MarkusMaximusMilanovici/Diplomarbeit/Simulationen_und_Dokumentationen/Dokumentationen/Schule/Präsentation-Jahresprojekt.pptx

## Black Mirror

- Diplomarbeit 22.05.2026

Robert Milanovici & Manuel Greinix
Abteilung für Elektronik und Technische Informatik

## Ziel

- Raspberry Pi Camera
- Silhouette erstellen
- Auf die LEDs Skalieren
- Anzeige

## Programm Start

- Initialization
- Kamera starten
- KI-Modelle
- KNN starten

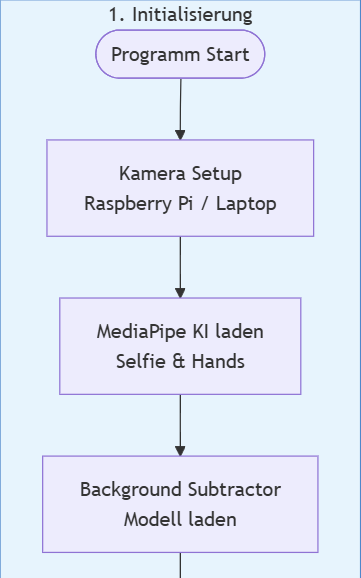
[picture p49: figure]

## Kalibrierung

- 100 Frames ( Keine Person )
- BGR -> Graustufenbild
- KNN lernt Hintergrund

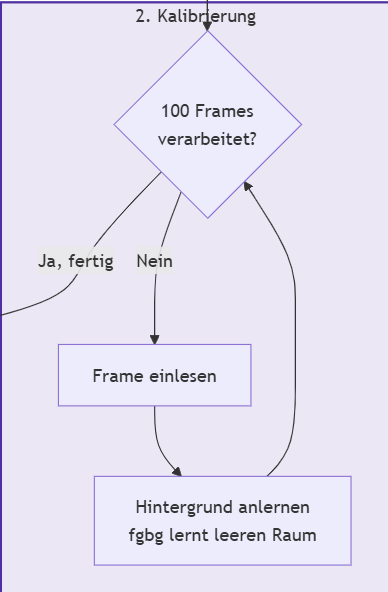
[picture p50: figure]

## Main Loop

- BGR -> RGB
- Körper von Hintergrund trennen
- Hände Polygon
- Maske erstellen

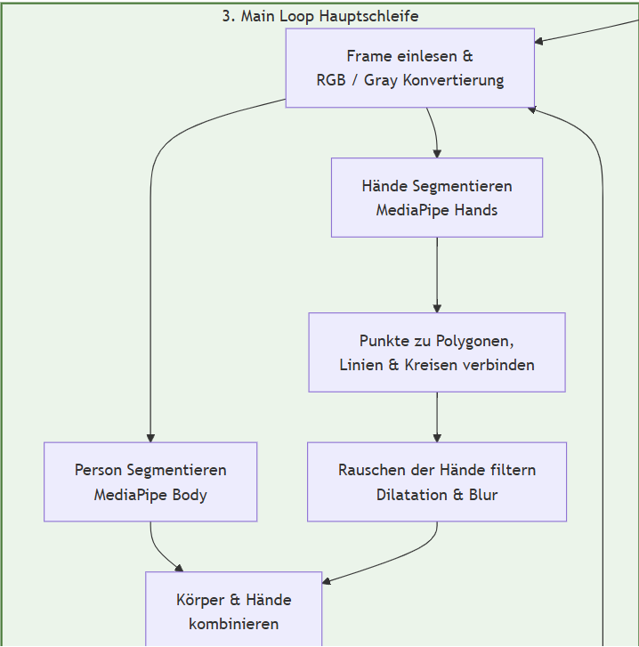
[picture p51: figure]

## Main Loop

- Filter
- Shilouette füllen
- Zeitliche Glättung
- Skalierung

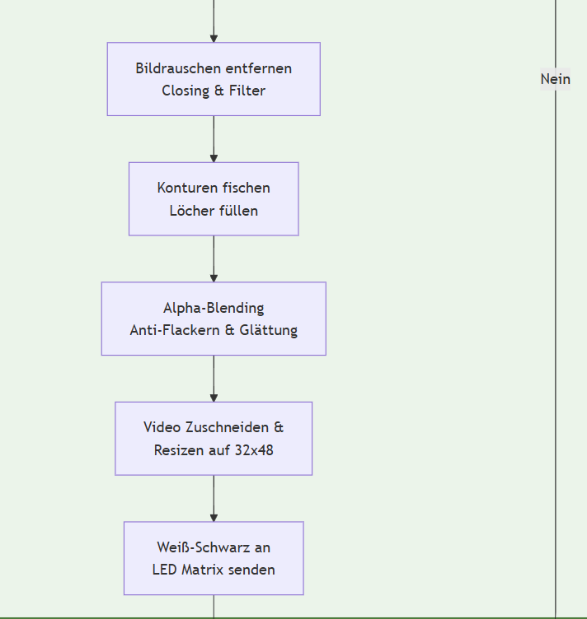
[picture p52: figure]

## Led-Matrix

## Manuel

- Manuel
- Bildübertragung auf LED-Matrix
- Case und Platinen Designe
- Case Fertigung
- Dokumentation und Github Verwaltung

## Neustrukturiereung Github

- Main-Rework
- Neuer Übersichtlicher Aufbau
  - Software
  - Simulation/Dokumentation
  - Setup Guid
- READMEs mir erklärungen
- Code-Archive

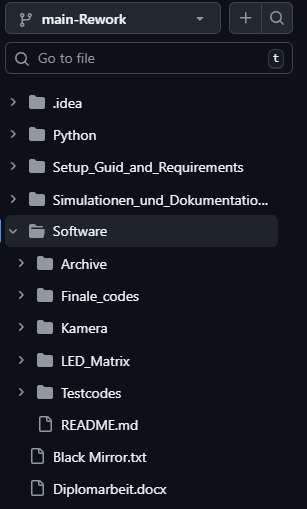
[picture p53: figure]

## Programm Start

- Initialization
- Prüfen ob Raspberry läuft
- Bild wird zerlegt
- 2. 4. und 6. Matrix wird geflippt
- In PIL-Image converten
- Anzeigen

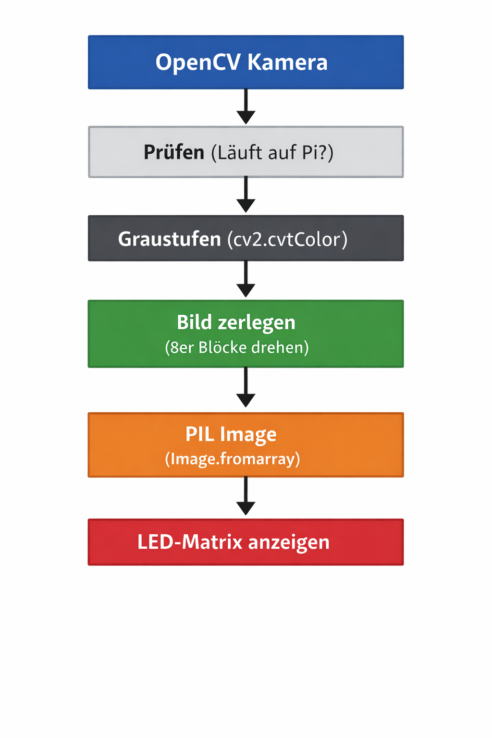
[picture p54: figure]

## Case Design


- Stichpunkte
- Material der Wahl : Holz
- Design Finalisiert
- Für Optimales gerades Bild
  - Opt1: LED-Matrix Einzelteile Abschleifen
  - Opt2: Neuabmessung der Platinen
- Wenn Genug Zeit Case2.0

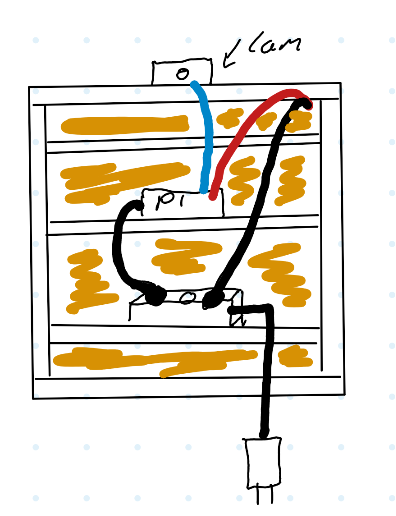
[picture p55: figure]
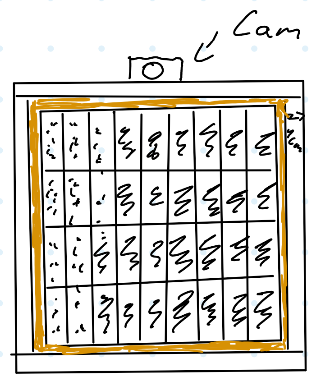
[picture p56: figure]

## Design der Platinen

- Stichpunkte
- Erster simpler Aufbau
- Redesign der neuen Platinen für neue Bauteile
- Bestellen

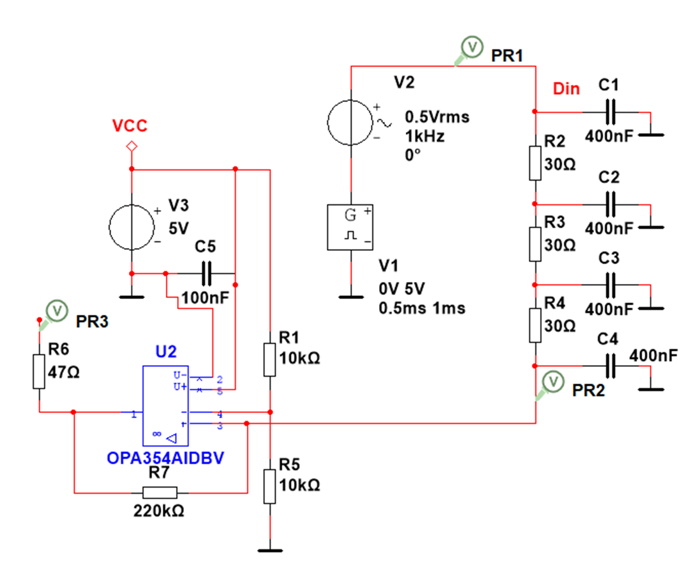
[picture p57: figure]

## Anstehende Punkte

- Finalen Code für die Bildübertragung
- Verbindungsplatinen bestellen, Testen, und Einbauen
- Case Zusammenbauen und Optimieren
- LED-Matrix Stabilisieren und Festigen

## Led Matrix

- OPV Schmit trigger Schaltung
- OPA354 -> hohe Frequenz & Slew Rate
- Signal (blau) wird repariert

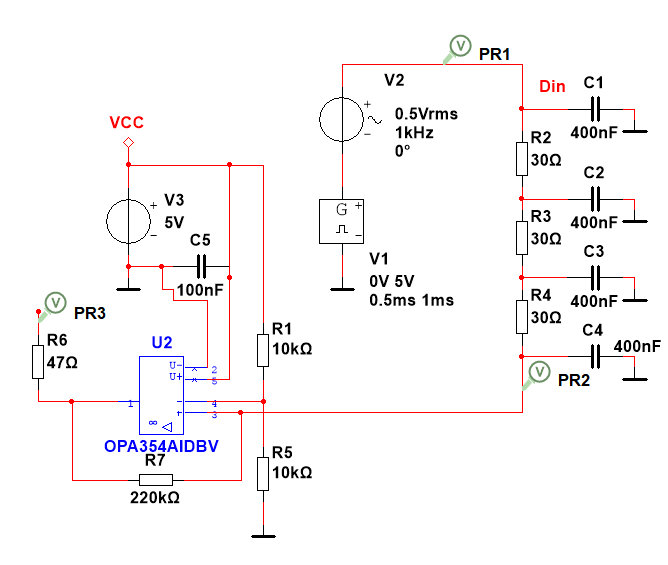
[picture p58: figure]
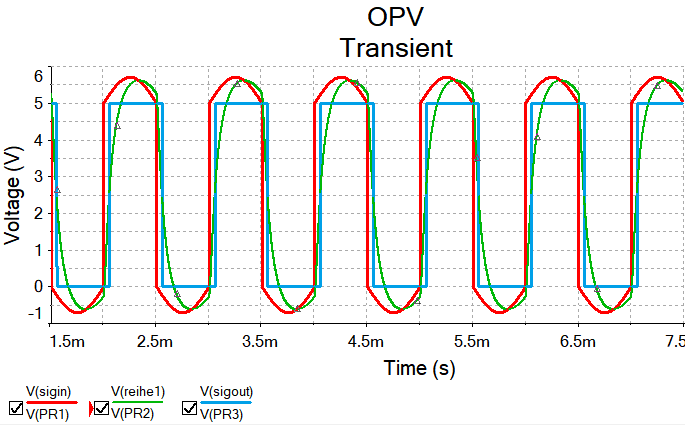
[picture p59: figure]

## Proof of Concept

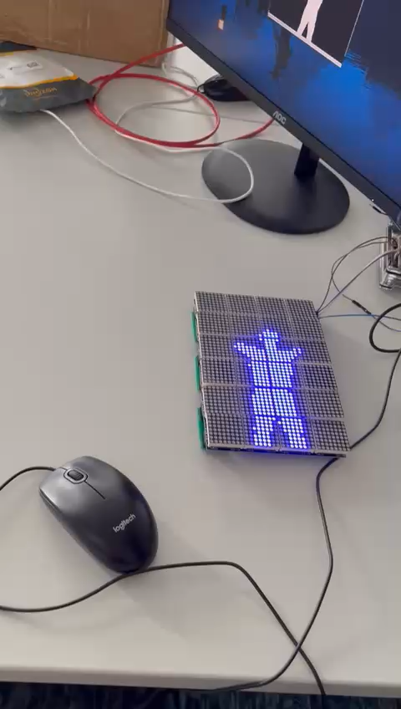
[picture p60: figure]

## Probleme

- Anfänglich:
- Eine stabile Silhouette erstellen
- Eine Case Idee
- Zurzeit:
- Alle 9 Reihen der Led anzusteuern
- Die Finger / Hand präzise anzeigen

## Besonders Aufwendig

- Stabile Silhouette
- Parameter
- Led Module vorbereiten
- Bauteile besorgen

## Aus dem Unterricht gelernt

- HWE / DIC: Hardware Debugging (Zwischenplatinen, OPV)
- DIC: Filter wie Erode und Dilate anwenden (Personenerfassung)

## Zusammenfassung

- ….wichtigste 3-4 Punkte
