MarkusMaximusMilanovici/Diplomarbeit/Simulationen_und_Dokumentationen/Dokumentationen/Schule/5BHEL_Greinix_Milanovici_BlackMirror.pptx

## Der Black Mirror

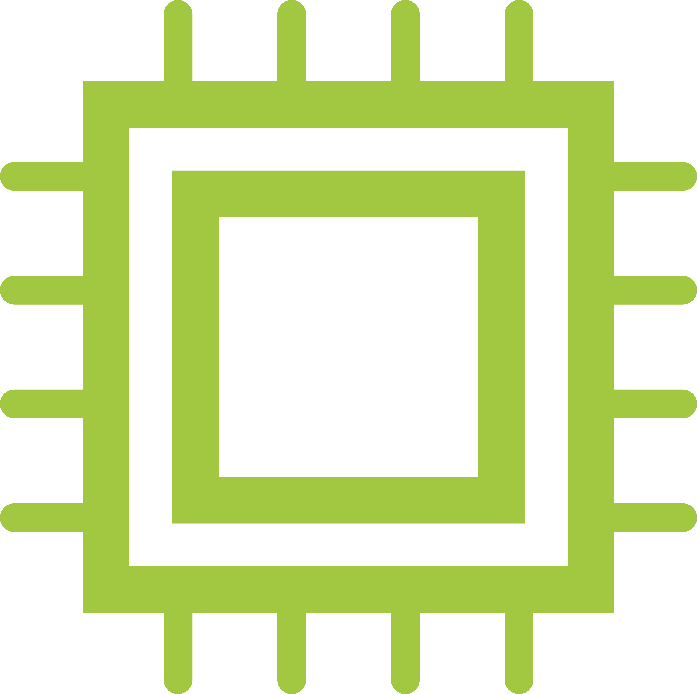
[picture p61: figure]

- Black Mirror spiegelt deine Bewegungen in Echtzeit als digitale Silhouette auf einer LED-Matrix wider.

Die Diplomarbeit „Black Mirror“ kombiniert Kamerasensorik mit künstlicher Intelligenz. Das System erfasst Personen in Echtzeit, trennt sie vom Hintergrund und wandelt ihre Gestik in eine stilisierte Silhouette um. Diese wird verzögerungsfrei auf einer LED-Matrix gespiegelt und erzeugt ein faszinierendes Zusammenspiel aus Bewegung und digitalem Abbild.

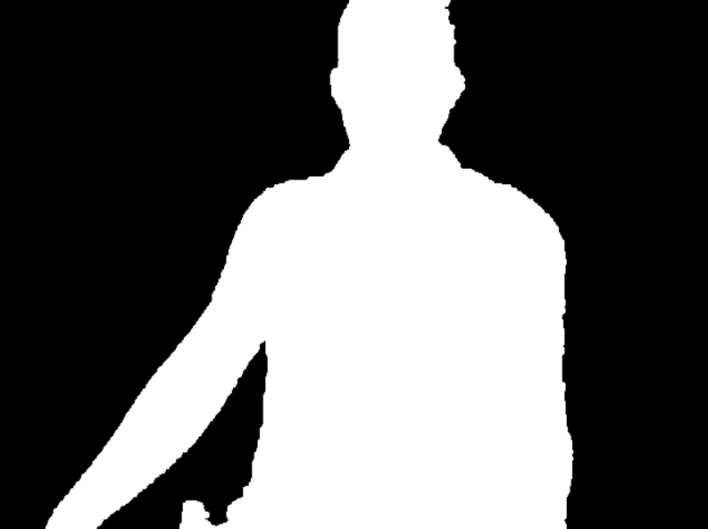
[picture p62: figure]
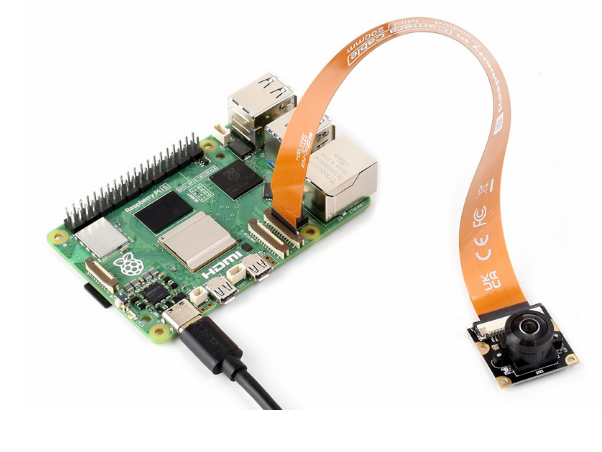
[picture p63: figure]
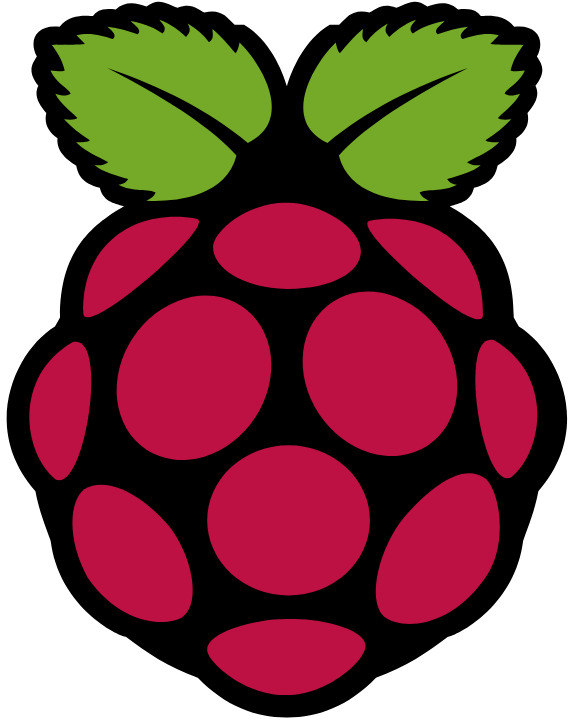
[picture p64: figure]

Verwendete Technologien
Raspberry Pi & PiCamera
Python, OpenCV & MediaPipe
Adressierbare LED-Matrix
CAD & 3D-Druck


LASS DEINE IDEEN LEBENDIG WERDEN

Betreuer

Diplomanden
Robert Milanovici
Manuel Greinix

Prof. DI Patz Franz Albert

Aufgabenbereich
Entwicklung der Bildverarbeitungs-Software
Implementierung der KI-Algorithmen
Hardware-Ansteuerung der LED-Matrix
Gehäusekonstruktion & 3D-Design

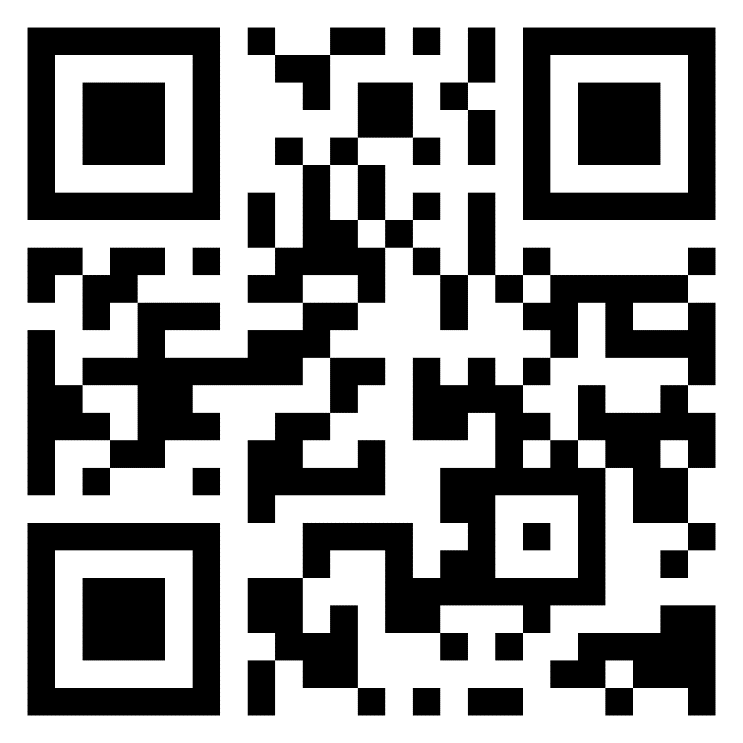
[picture p65: figure]
