MarkusMaximusMilanovici/Diplomarbeit/Simulationen_und_Dokumentationen/Dokumentationen/Diplomarbeit_Verzeichnise/Lastenheft-BlackMirror (1) (1).docx

# 1 Projektziel

Spezifisch:
Es soll ein System namens BlackMirror entwickelt werden, das mithilfe einer Kamera Objekte und Personen erkennt und die erfassten Bilder bzw. eine abstrahierte Darstellung in Echtzeit auf einer LED-Matrix (29 × 52 cm) visuell wiedergibt.

Messbar:
Das System gilt als erfolgreich umgesetzt, wenn folgende Punkte erfüllt sind:
- Kamera kann Personen und Objekte zuverlässig erfassen.
- Erfasste Bilddaten werden auf der LED-Matrix korrekt dargestellt.
- Darstellung erfolgt mit einer sinnvollen Bildrate ohne wahrnehmbare Verzögerung.

Attraktiv:
BlackMirror kombiniert moderne Bilderkennung mit kreativer Visualisierung. Es ist technisch spannend (Computer Vision, Elektronik, LED-Steuerung) und ästhetisch ansprechend – ideal für Ausstellungen, smarte Displays oder interaktive Kunstprojekte.

Realistisch:
Mit gängigen Komponenten (z. B. Raspberry, LED-Matrix, Python/OpenCV) ist das Projekt im Rahmen von Schulressourcen und Teamgröße realisierbar.

Terminiert:
Das Projekt wird innerhalb des vorgegebenen Zeitrahmens (ca. 250–300 Stunden) umgesetzt. Der erste funktionsfähige Prototyp soll bis zum Tag der offenen Tür März 2026 präsentiert werden.

# 2 Nutzen des Produktes

- Vorteile
  - BlackMirror verbindet Technologie, Kunst und Interaktion – es zeigt in Echtzeit, wie Technik menschliche Bewegung und Präsenz erfassen kann.
- Beschreibung
  - Das System erkennt eine Person oder ein Objekt vor der Kamera und spiegelt die erfassten Formen oder Silhouetten auf einer LED-Matrix wider – wie ein „digitaler Spiegel“.
- Welchen Nutzen/Vorteil hat der Anwender des Produkts gegenüber vorher?
  - Visuell beeindruckendes, interaktives Display.
  - Lässt sich an viele Einsatzszenarien anpassen (z. B. Kunst, Werbung, Bildung und Dekoration).
- Nachteile bei nicht Realisierung des Produktes
  - Fehlende innovative Projektarbeit im Bereich Computer Vision.
  - Verpasste Chance kreative Technologie zu präsentieren.
- Welchen Vorteil hat das Projektergebnis gegenüber anderen/eventuell bereits bestehenden Lösungen?
  - Kombination aus Echtzeit-Bilderkennung und großflächiger LED-Visualisierung ist selten.
  - Hoher Wiedererkennungswert durch die interaktive Darstellung.

# 3 Kunden, Anwender, Zielmarkt

- Auftraggeber/Endnutzer
  - Auftraggeber: Projekt/Diplomarbeit Endnutzer: Kunst & Designliebhaber , Dekoration Öffentlicher Flächen wie z.B: Einkaufszentren DIY-Smart-Home Umfeld Mögliche Interessenten: Installationen in Galerien oder Events.
- Mögliche Interessenten nach Adaption
  - Büros & Co-Working-Spaces
- Berührungspunkte
  - Endnutzer
  - Entwickler / Techniker (Installation & Wartung)
- Potenzielle Anbieter des Produktes
  - Elektronik- oder Maker-Shops, Bildungseinrichtungen, Smart-Display-Hersteller, Großhändler.

# 4 Anforderungen

- Hauptfunktionen:
  - Kameraerfassung von Personen oder Objekten.
  - Verarbeitung des Bildes (z. B. Kantenerkennung, Silhouettierung).
  - Ausgabe auf einer LED-Matrix.
- Potenzielle Anforderungen / Extrawünsche des Kunden
  - Spezialanfertigungen (Größe, bzw Material)
- Mögliche Zusatzfunktionen
  - Erkennung mehrerer Personen gleichzeitig.
  - Anpassbare Darstellung (z. B. Kontrast, Auflösung).
- Verbesserung des Produkts
  - Hochwertigeres Grunddesign bzw Case
- „nice to have“?
  - Personalisierung des außen Designs Möglichkeiten (Muster ,generelles Design Selber bei kauf optional Festlege)
- Wichtige Attribute
  - Stabiler Betrieb ohne Verzögerungen.
  - Kompakte, ästhetische Bauform.
  - Energieeffiziente Steuerung der LED-Matrix.

# 5 Randbedingungen

- Unveränderliche Eigenschaften
  - Kamera
  - LED Matrix
  - Maximalgröße (wegen Budget)
- Kompatibilität
  - Evtl. Smartphone
- Versorgung
  - Netzteil

# 6 Chancen und Risken

- Lokale Märkte für das Produkt
  - Einkaufszentren , Haushalte
- Voraussichtliche Kundenfelder
  - Private Haushalte mit Technikaffinität: Österreich hat ca. 4 Mio. Haushalte – ein kleiner, aber technikinteressierter Teil (~1–2 %) davon wäre potenziell interessiert. → ca. 40.000–80.000 Haushalte
  - Kleinunternehmen & Büros: Etwa 350.000 Unternehmen, viele davon Kleinbetriebe oder Kanzleien, wollen vielleicht technologische Dekoration → ca. 500 –100 potenzielle Firmenkunden
  - Maker-Szene / Bildungseinrichtungen: Schulen, FHs, Tüftler – kleinere Stückzahlen, aber hohes Interesse an Innovation. → ca. 1.000–2.000 Verkäufe/Jahr
- Voraussichtliche Verkäufe Pro Jahr( Exponentiell mehr pro Jahr)
  - Zwischen 500-1500 im Jahr
- Verglichen mit der Konkurrenz
  - Innovativ und hat keinen wirklichen Vergleich
- Kosten für das Produkt
  - Zwischen 350-400€
- Nicht einplanbare Hindernisse
  - Attraktivität des Produktes bei Käufern
- Externer Gebrauch der Benötigt wird
  - Bei Verkaufbaren Produkt: Zusatzzubehör wie Kabel und Stromversorgung

# 7 Aufwandsabschätzung

- Herstellungskosten des Prototypen
  - Gesamt ca 350 Euro
- Kosten des Produktes
  - Hardware | Kamera, µC, LED-Matrix, Netzteil | ca. 300 €
  - Sonstiges | Kabel, Gehäuse, Halterungen | ca. 50 €
- Zeit die für Entwicklung gebraucht werden wird
  - 250-300 Stunden
- Anzahl notwendiger Mitarbeiter
  - 2 Personen
- Wichtige Kenntnisse der Arbeiter
  - Hardwaredesign
  - Bibliotheken: OpenCV, LED-Matrix-Controller
  - Programmierung (Python / OpenCV)
  - Optional: 3D-Druck
- Ist externe Unterstützung notwendig?
  - Zu diesem Zeitpunkt nicht beurteilbar, voraussichtlich wenig Unterstützung nötig
- Fertigstellung des Ersten Prototypen
  - Ziel : Tag der offenen Tür
- Start für eine Serienfertigstellung
  - Ende 2027
- Kosten Pro Stück
  - 550€

WS2000 Projektantrag.doc 14 von 1

Greinix/Milanovici Seite 1 von 2

Skriptum Technische Informatik

Lastenheft BlackMirror Klasse 5BHEL 01.03.2026 Version 1.0
