MarkusMaximusMilanovici/Diplomarbeit/Simulationen_und_Dokumentationen/Dokumentationen/Diplomarbeit_Verzeichnise/Verzeichnis_Diplo.docx

1. Einleitung

1.1 Motivation und Problemstellung
1.2 Zielsetzung der Diplomarbeit
1.3 Abgrenzung und Rahmenbedingungen
1.4 Aufbau der Arbeit

2. Grundlagen

2.1 Bildverarbeitung und Computer Vision
2.2 Künstliche Intelligenz in der Bildanalyse
2.3 Medien- und LED-Display-Technik
2.4 Git, Versionsverwaltung und Entwicklungsumgebung

3. Analyse und Anforderungen

3.1 Ausgangssituation und Ideenfindung („Black Mirror“)
3.2 Funktionale Anforderungen (Was soll das System können?)
3.3 Nicht-funktionale Anforderungen (Echtzeit, Robustheit, Sicherheit)
3.4 Use Cases und Szenarien
3.5 Systemgrenzen und Annahmen

4. Systemkonzept und Architektur

4.1 Gesamtüberblick des Systems
4.2 Hardwarearchitektur
4.2.1 Raspberry Pi und Kamera
4.2.2 LED-Matrix und Ansteuerung
4.2.3 Weitere Komponenten (Netzteil, Rahmen, Gehäuse)
4.3 Softwarearchitektur
4.3.1 Schichtenmodell und Module
4.3.2 Datenfluss vom Kamerabild zur LED-Matrix
4.3.3 Schnittstellen zwischen den Komponenten

5. Verwendete Technologien

5.1 Programmiersprache und Bibliotheken (Python, OpenCV, NumPy)
5.2 MediaPipe Selfie Segmentation und Hands
5.3 Bildverarbeitungs- und Filterverfahren (Thresholding, Morphologie, Kanten)
5.4 Kommunikations- und Protokollkonzepte zur LED-Ansteuerung
5.5 Entwicklungswerkzeuge (IDE, GitHub, Testumgebung)

6. Implementierung

6.1 Vorbereitung und Initialisierung der Kamera
6.2 Vorverarbeitung der Kamerabilder
6.2.1 Helligkeits- und Kontrastanpassung
6.2.2 Grauwertbilder, Rauschunterdrückung
6.3 Personensegmentierung mit MediaPipe (Selfie Segmentation)
6.3.1 Erzeugung der Binärmaske
6.3.2 Umgang mit Beleuchtung und Threshold-Wahl
6.4 Hand- und Fingererkennung mit MediaPipe Hands
6.4.1 Landmarkerkennung
6.4.2 Einzeichnen der Hände in die Silhouettenmaske
6.5 Hintergrundmodell und Bewegungserkennung (KNN-Subtractor)
6.5.1 Kalibrierungsphase
6.5.2 Nutzung der Bewegungsmaske
6.6 Nachverarbeitung der Maske
6.6.1 Morphologische Operationen (Erosion, Dilatation, Opening, Closing)
6.6.2 Konturenerkennung und Füllen der Silhouette
6.6.3 Zeitliche Glättung der Maske (Frame-übergreifende Stabilisierung)
6.7 Downscaling und Mapping auf die LED-Matrix
6.7.1 Auflösung und Skalierungsstrategien
6.7.2 Umsetzung in das Matrix-Koordinatensystem
6.8 Softwarestruktur und wichtige Codeausschnitte

7. Mechanischer Aufbau und Design

7.1 Gehäusekonzept und Gestaltung des Spiegels
7.2 Montage der LED-Matrix und Kamera
7.3 Kabelmanagement und Sicherheit
7.4 Designüberlegungen (Ästhetik, Benutzerfreundlichkeit)

8. Tests und Evaluierung

8.1 Teststrategie und Testumgebung
8.2 Funktionstests (Erkennung, Anzeige, Bedienung)
8.3 Performance-Messungen (FPS, Latenz)
8.4 Robustheitstests (verschiedene Lichtbedingungen, Kleidung, Hintergründe)
8.5 Grenzen des Systems und typische Fehlerfälle
8.6 Auswertung der Testergebnisse

9. Benutzeroberfläche und Bedienkonzept (falls vorhanden)

9.1 Starten und Beenden des Systems
9.2 Konfigurationsmöglichkeiten (z.B. Helligkeit, Thresholds)
9.3 Benutzerfeedback und Beobachtungen

10. Wirtschaftliche und gesellschaftliche Betrachtung (falls von Schule gefordert)

10.1 Kostenanalyse der Hardware
10.2 Einsatzmöglichkeiten (Schule, Kunstinstallation, Messe, Werbung)
10.3 Datenschutz und ethische Überlegungen (Kamera, Aufnahmen)

11. Zusammenfassung und Ausblick

11.1 Zusammenfassung der erzielten Ergebnisse
11.2 Erfüllung der Zielsetzung
11.3 Mögliche Erweiterungen (z.B. Farben, Gestenerkennung, Multiplayer)
11.4 Persönliche Reflexion

12. Literaturverzeichnis

13. Abbildungsverzeichnis

14. Tabellenverzeichnis (optional)

15. Anhang

15.1 Quellcode-Auszüge
15.2 Schaltpläne und Anschlussdiagramme
15.3 CAD-Zeichnungen / 3D-Modelle
15.4 Testprotokolle und Messdaten
