MarkusMaximusMilanovici/Diplomarbeit/Software/README.md

## Strukturierender Aufbau unserers Software teils der Diplomarbeit
