MarkusMaximusMilanovici/Diplomarbeit/Software/Finale_codes/README.md

## Finale Codes

Hier werden die finalen codes für das Endprodukt sein
