MarkusMaximusMilanovici/Diplomarbeit/Software/Kamera/README.md

## Detection_with_Mediapipe
### Dieser Code wurde für die Personenerkennung des Balck Mirrors endgültig verwendet 
  Die Personenerfassung und die wandlung auf schwarz und weiß mit KI model Mediapipe durch Errode und Dilate, KNN Subtractor, Kantenerkennung und Opening und Closing
