MarkusMaximusMilanovici/Diplomarbeit/Software/Archive/README.md

## Archive

Hier werden die abgeschlossenen neben projekte und test Archiviert damit man jeder zeit wieder nachschauen kann.
