MarkusMaximusMilanovici/Diplomarbeit/Simulationen_und_Dokumentationen/Dokumentationen/Diplomarbeit_Verzeichnise/Code.png

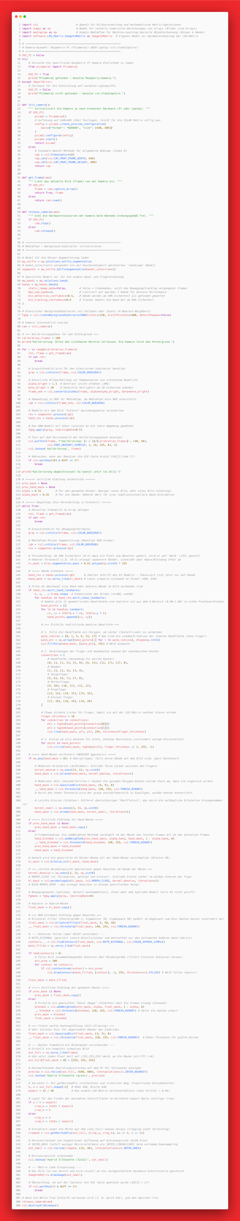
Simulationen_und_Dokumentationen/Dokumentationen/Diplomarbeit_Verzeichnise/Code.png
