MarkusMaximusMilanovici/Diplomarbeit/Simulationen_und_Dokumentationen/Dokumentationen/Diplomarbeit_Verzeichnise/Personenerfassung_Flowchart.png

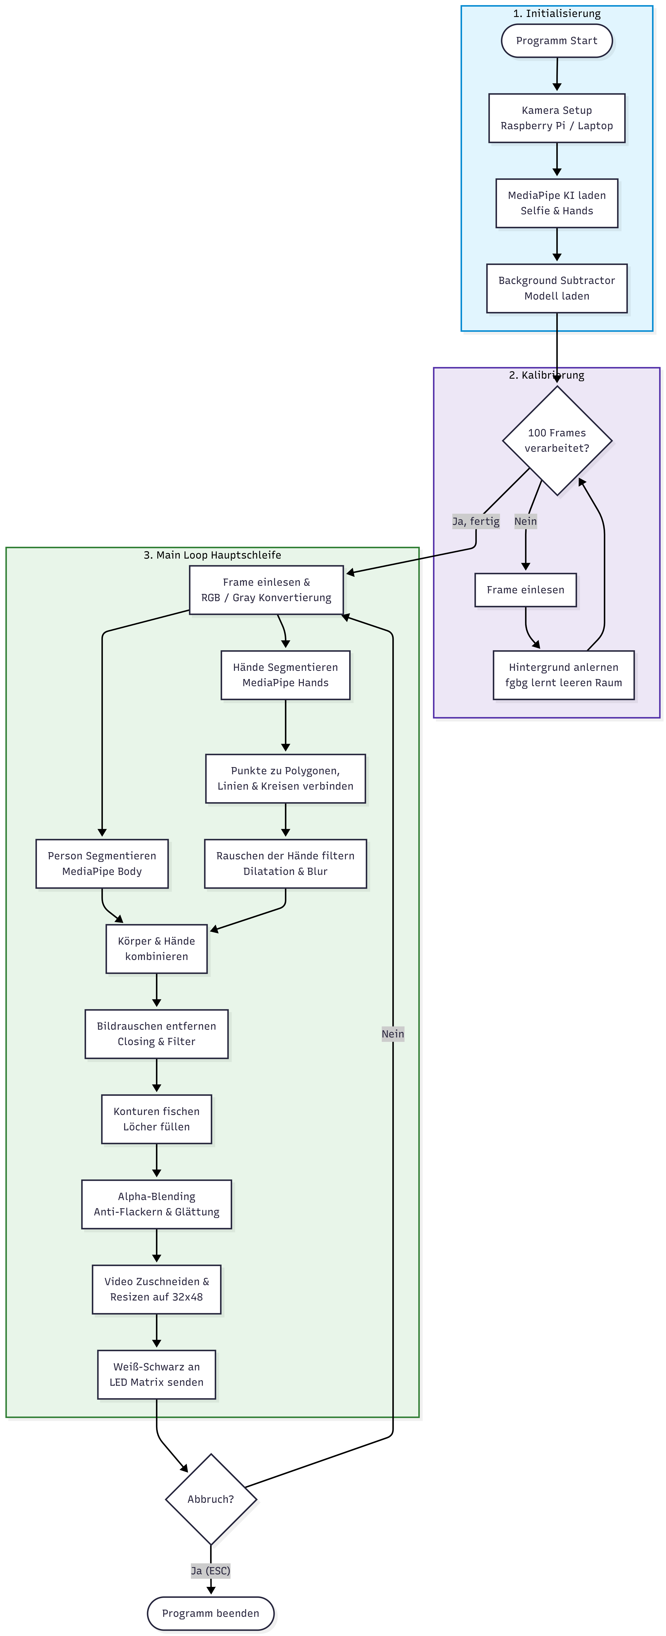
Simulationen_und_Dokumentationen/Dokumentationen/Diplomarbeit_Verzeichnise/Personenerfassung_Flowchart.png
