MarkusMaximusMilanovici/Diplomarbeit/Simulationen_und_Dokumentationen/Dokumentationen/Diplomarbeit_Verzeichnise/Kostentabelle.xlsx

 | BESCHREIBUNG | MENGE | MODELLNUMMER/TEILENUMMER | HERSTELLER-TEILENUMMER | Website | Link | STÜCKPREIS | Versand | GESAMTPREIS
1 | Raspberry Pi 5 8 GB | 1 | Raspberry Pi 5 | Raspberry Pi | Amazon | https://www.amazon.de/dp/B0CK2FCG1K?ref_=ppx_hzod_title_dt_b_fed_asin_title_0_0 | €90.45 |  | €90.45
2 | Twozoh Micro HDMI auf HDMI Kabel 1M | 1 | 1M | Twozoh | Amazon | https://www.amazon.de/dp/B08RB1HKKB?ref_=ppx_hzod_title_dt_b_fed_asin_title_0_2&th=1 | €9.89 |  | €9.89
3 | Raspberry Pi 5 USB-C Netzteil | 1 | EB82182 | Raspberry Pi | Amazon | https://www.amazon.de/dp/B0CN3MRV16?ref_=ppx_hzod_title_dt_b_fed_asin_title_1_0 | €15.90 |  | €15.90
4 | Miuzei Gehäuse für Raspberry Pi 5 | 1 | Boîtier pour Raspberry Pi 5 | Miuzei | Amazon | https://www.amazon.de/dp/B0CN3MRV16?ref_=ppx_hzod_title_dt_b_fed_asin_title_1_0 | €10.99 |  | €10.99
5 | ZDE 2 Stück Kamera Kabel CSI FFC | 1 | ZDE 2PCS | ZDE | Amazon | https://www.amazon.de/dp/B0DQ9KYNB3?ref_=ppx_hzod_title_dt_b_fed_asin_title_2_0 | €7.99 |  | €7.99
6 | Raspberry Pi Camera Modul 3 Wide NoIR | 1 | SC0875 | Raspberry Pi | Amazon | https://www.amazon.de/dp/B0BRY6VLR6?ref_=ppx_hzod_title_dt_b_fed_asin_title_3_1 | €30.99 |  | €30.99
7 | 1 Stück MAX7219 Dot Matrix Modul | 40 | -------------------------------- | --------------- | AliExpress | --------------------------------------------------------------------------------------------------------------- | 2.65 | €47.24 | €152.63
8 | 10 Stück 2,54mm/2mm u-Form einreihiger Stecker | 1 | RA DIP 2.54mm Pin Header | Yu Na Sheng | AliExpress | https://de.aliexpress.com/item/1005007029727065.html | 4.89 | €4.00 | €8.89
9 | Arceli 120 Stück 2,54 mm Gerade einreihige Stieftleisten | 1 | 00 454 | Arceli | Amazon | https://www.amazon.de/dp/B07Q1XBGFB?ref_=ppx_hzod_title_dt_b_fed_asin_title_0_0 | €9.99 |  | €9.99
10 | IC OPAMP VFB 1 CIRCUIT SOT23-5 | 20 | 296-13033-1-ND | OPA354AIDBVT | DigiKey | https://www.digikey.at/de/products/detail/texas-instruments/OPA354AIDBVT/480150 | 1.769 |  | €35.38
11 | RES 10K OHM 5% 1/4W AXIAL | 40 | CF14JT10K0CT-ND | CF14JT10K0 | DigiKey | https://www.digikey.at/de/products/detail/stackpole-electronics-inc/CF14JT10K0/1741265 | 0.0124 |  | €0.50
12 | RES 47 OHM 10% 2W AXIAL | 20 | BC3362CT-ND | PR02FS0204709KR500 | DigiKey | https://www.digikey.at/de/products/detail/vishay-beyschlag-draloric-bc-components/PR02FS0204709KR500/6691138 | 0.239 |  | €4.78
13 | IC BUFF NON-INVERT 5.5V 14-PDIP | 3 | 296-4655-5-ND | SN74AHCT125N | DigiKey | https://www.digikey.at/de/products/detail/texas-instruments/SN74AHCT125N/375798 | 0.69 |  | €2.07
14 | SWITCH ROCKER SPST 10A 125V | 1 | EG5619-ND | RA1113112R | DigiKey | https://www.digikey.at/de/products/detail/e-switch/RA1113112R/3778055 | 0.55 |  | €0.55
15 | +5V2.4A;18AWG/150CM | 1 | 1866-NGE12E05-P1J-ND | NGE12E05-P1J | DigiKey | https://www.digikey.at/de/products/detail/mean-well-usa-inc/NGE12E05-P1J/22118921 | 9.08 |  | €9.08
16 | Holzplatte 20x70 cm | 4 | ------------------------------ | --------------------------------- | Obi Markt |  |  |  | €16.96
17
 |  |  |  |  |  |  |  | mwst. | €10.47
 |  |  |  |  |  |  |  |  | 417.51 €
