MarkusMaximusMilanovici/Diplomarbeit/Software/Testcodes/README.md

## Codes die Grade in verwendung sind die noch nicht ready zum Archivieren sind
