MarkusMaximusMilanovici/Diplomarbeit/Software/Archive/Erster_Kamera_Test/README.md

## main.py

### Testprogramm zur Überprüfung der Kamerafunktion am Raspberry Pi

`main.py` diente in dieser Entwicklungsphase ausschließlich zur grundlegenden Überprüfung der Kamerafunktionalität am Raspberry Pi.

Ziel dieses Programms war es, sicherzustellen, dass:

- die Kamera korrekt erkannt und initialisiert wird  
- ein Livebild ausgegeben werden kann  
- die Auflösung den Anforderungen des Projekts entspricht  
- die Bildqualität der NoIR-Kamera ausreichend ist  

Im Rahmen dieses Tests wurde die Kamera eingeschaltet und das aufgenommene Bild analysiert, um ein erstes Gefühl für:

- Helligkeit  
- Kontrast  
- Bildschärfe  
- Reaktionszeit  

zu erhalten.

Dieses Programm stellte somit eine grundlegende Funktionskontrolle dar und bildete die Basis für die spätere Implementierung der Bildverarbeitung und Personenerkennung.

Es enthält bewusst nur elementare Funktionen und dient nicht als Bestandteil des finalen Systems, sondern als technischer Funktionstest der Hardware.
