MarkusMaximusMilanovici/Diplomarbeit/(list of files, drawings)

Other design files:
Simulationen_und_Dokumentationen/Simulationen/LevelShifter.ms14
Simulationen_und_Dokumentationen/Simulationen/OPV.ms14
