MarkusMaximusMilanovici/Diplomarbeit/(commit log)

2025-11-21 Das gleiche nur mit filter hinterher für mehr detail und pixelentfernung
2025-11-26 Vor dem Knn BAckground Subtractor eine Kalibrierung mit 100 Bilder um zu schauen welche Pixel sich wie ändern und den HIntergrund mit der Person besser zu trennen
2025-11-26 Errode und Dilate nach dem Canny mit 5x5
2025-11-26 Errode und Dilate nach dem Canny mit 5x5 2 mal ausführen
2025-11-26 Errode und Dilate nach dem Canny mit 5x5 vor und nach dem Canny ausführen
2025-11-26 Errode und Dilate nach dem Canny mit 5x5 vor und nach dem Canny ausführen. ISt schlechter weil das errode und Dilate anfänglich auf Graustufenbild. dannch auf binär(schwarz weiß)
2025-11-26 Vor dem Canny ein Errode und dilate, weil einfacher für canny, dann canny, dannch nochmal ein opening und closing für edge map sauberer machen
2025-12-04 mit Picamera anstatt VideoCApture und verwendbar für laptop und Pi
2025-12-04 Das Bild wird um 90 Grad gedreht weil die KAmera4:3 ist und es wird so downgescaled, dass die Leds von 128x72 Pixel das genau anzeigen
2025-12-04 Das Bild wird um 90 Grad gedreht weil die KAmera4:3 ist und es wird so downgescaled, dass die Leds von 128x72 Pixel das genau anzeigen und es wird mit voller Auflösung gerechnet und erst am Ende dowg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
2025-12-04 jetzt wird 32:32 weil das auf die jetztigen Leds abgespielt werden kann
2025-12-04 der Output wird auf der MAtrix angezeigt
2025-12-26 ein bisschen mit den ZAhlen gespielt Threshold und anstadt Maske Konturen verwendet am Ende, soll das Rauschen etwas wegmachen und die Finhger sollen durch die Zahlen Spielerei und durch das Closing 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
2026-01-07 Da die Finger bzw die HAnd nicht gefasst wird, hab ich von MEdiaPipe das HAndtracking genommen wo an den Knöcheln der HAnd Punkte miteinander verbunden. Um die Punkte sollen kleine kreise gemacht wer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
2026-01-07 Den Radius der Kreise kleiner gemacht und am closing der Morpholgie das iterations von 2 auf 1 gewechselt
2026-01-07 Der KNN Subtractor hat ein umgekehrtes Bild Bekommen anfänglich und dannch wieder umgedreht, jetzt bekommt es ein normales Bild
2026-01-07 tracking confidence erhöht von 0.5 auf 0.7 und eine zeitliche Glättung eingefügt wo das letzte Bild mitspielt damit die Hand nicht sofort verschwindet oder wie vorher das sie kurz einfach weggeht
2026-01-08 Helligkeit erhöht damit wenn wie heute schlechtes Licht ist und die Ki bekommt das Bild heller
2026-01-28 mp_hands um etwas kleiner und größer gemacht
2026-01-28 radius der hand kreise größer
2026-01-28 die lienen vom HAndtracking wurden mitaufgenommen also wurden diese entfertn indem nur die punkte angezeigt werden und die linen in den Fingern dicker, gausssian blur hinzugefügt
2026-01-28 linien auf 8 und radius auf 5 und kernel auf 3,3 genauer, min area = 200 nicht mehr nur drei Finger angezeigt gaussian auf 3,3
2026-01-29 zu gober blur und und zu starker Dilation. Weniger Rauschen höhere seg Threshold werte. weniger tmp glättung
2026-03-01 der bisherige Stand. die Sihlouette is gut aber die Hände sind noch immer problematisch. sie werden angezeigt und falls die KI nachlässt helfen die Lanmarklinien aber die Finger verschwimmen oft mite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
    [Detection_with_Mediapipe.py]
2026-03-01 paar texte
    [OPV.ms14, SchmiddOPV.ms14]
2026-03-04 Die Punkte zwischen den Gelenken dynamisch also radius passt sich an und gefüllte Handfläche
2026-03-04 Simulation und Dokumentationsfolder
    [OPV.ms14, SchmiddOPV.ms14]
2026-03-28 Kommentare und Code erklärung
2026-04-02 Doku und png von Code
2026-04-16 Die letzten Commits vor der Abgabe
    [Kopie von Kostentabelle.xlsx]
